yussefz99/Smart-Doorbell/Documentation/user_stories_smart_doorbell_final_trimmed.docx

Smart Doorbell – Group 15

A smart IoT doorbell with a camera that sends real-time photo notifications, recognises returning visitors, and lets the homeowner monitor and manage all door activity remotely via Telegram.

User Types

User Type | Description
Homeowner (Admin) | Full access: receives notifications, views history, manages settings, registers known visitors, and controls all device behaviour.
Family Member | Can view notifications and visit history. Cannot change settings or manage visitor profiles.
Guest / Delivery Person | Interacts only via the physical doorbell button. No app or internet access required.

User Stories (sorted by importance to the project)

# | Story Name | As a... | I want... | So that...

1 | Doorbell Notification | Homeowner / Family Member | to receive an instant notification with a photo on my phone when someone rings the doorbell | I know who is at the door immediately, even when I'm not home
2 | Visitor Recognition | Homeowner | the system to automatically recognise returning visitors and display their name in the notification | I can see at a glance whether it is someone I know without comparing photos manually
3 | Register a Known Visitor | Homeowner | to register a person by name so the system recognises them in future visits | I stop receiving 'unknown visitor' alerts for people I know
4 | Visitor Acknowledgment | Homeowner / Family Member | to respond to a doorbell notification with a quick reply button ('On my way', 'Not home') | my response is logged with the visit and I do not need to type a message
5 | Visit History | Homeowner | to view a log of past visits with photos, timestamps, and my responses | I can review who came to my door and when, even after the fact
6 | Device Status Indicator | Homeowner / Guest | the LED on the device to clearly indicate when it is capturing a photo, and to signal errors with a distinct blink pattern | anyone near the door can tell at a glance whether the device is working correctly
7 | Notification Settings | Homeowner | to configure quiet hours during which doorbell notifications are delivered silently but still recorded | I am not disturbed at night while every ring is still saved in my history
8 | Visit Statistics | Homeowner | to see a summary of door activity over time (busiest hours, number of visits per day) | I can understand patterns at my entrance and spot unusual activity
9 | Mark a Visit | Homeowner | to tag any visit in the history as 'Expected', 'Unknown', or 'Suspicious' | I keep my visit log organised and can flag unusual events for follow-up
10 | Edge Case – Camera Failure | Homeowner | to receive a notification if the camera fails to capture a photo during a visit | I know a visit occurred even without a photo and can investigate the issue
11 | Admin / Technician Mode | Homeowner | to access a diagnostic view showing device uptime, WiFi signal, last sync time, and recent errors | I can troubleshoot device problems myself without physically accessing it
12 | Physical Doorbell Ring | Guest / Delivery Person | to press a physical button on the device to alert the homeowner | I can notify the resident of my arrival without needing an app or internet access
13 | Away Mode Auto-Reply | Homeowner | to turn on an 'Away Mode' with a preset message that automatically replies to a visitor when the doorbell is pressed | the caller gets an immediate response and it is logged with the visit, even when I am not available to answer myself

Links to References, Projects and Tutorials

# | Relevance to Our Project | Related to User Stories | Link

1 | ESP32-CAM Doorbell with Telegram – photo capture and notification on button press | 1, 4, 6, 12 | https://randomnerdtutorials.com/esp32-cam-telegram-photo-notification/
2 | Raspberry Pi Smart Doorbell – camera, button, and notification integration reference | 1, 5, 8, 9 | https://www.instructables.com/Raspberry-Pi-Smart-Video-Doorbell/
3 | Face recognition with pre-trained models (backend, no custom training) – visitor identification | 2, 3 | https://github.com/serengil/deepface
4 | Telegram Bot API – sending photos, inline keyboards, commands | 1, 4, 7, 8, 11 | https://core.telegram.org/bots/api
5 | Ring Doorbell – commercial product reference for feature scope and UX patterns | 1, 5, 7, 8 | https://ring.com/doorbell-cameras

List of Hardware Used

Final hardware in the built prototype. Controller confirmed from the available catalog; remaining parts are standard lab components.

# | Part / Function | Why We Need It

1 | ESP32-CAM with camera (+ USB-Serial adapter for flashing) ★ CONFIRMED | Core controller: built-in camera and WiFi. Captures photos on button press and sends them to the backend. Face recognition runs on the backend server — no processing on the microcontroller.
2 | Push button | Physical doorbell trigger pressed by the guest. Core hardware interaction — directly drives user stories #1 and #12.
3 | Built-in flash LED (GPIO 4) | Visual feedback of device state: lights while capturing a photo and blinks a distinct pattern on error. Supports story #6. Uses the ESP32-CAM's on-board LED — no extra GPIO required.
4 | 5V power supply / USB Micro cable | Powers the ESP32-CAM continuously via Micro USB — the device must always be on and ready to detect events.
5 | Breadboard + jumper wires + resistors | Prototyping and connecting the button to the ESP32-CAM. ESP32-CAM GPIO operates at 3.3V logic.
