yussefz99/Smart-Doorbell/(commit log)

2026-06-08 Add firmware, backend, dashboard, and project docs
    - ESP32 firmware steps 1-5 (button, WiFi+Telegram, camera, photo, complete V1)
    - FastAPI backend with SQLite, Telegram webhook, WebSocket live updates
    - Dashboard HTML and project planning/handoff docs
    - .gitignore to exclude secrets (.env), database, and runtime data
2026-06-08 Redact credentials from firmware and docs
    Replace real bot token, WiFi credentials, and chat ID with placeholders.
    [doorbell_step2_wifi_telegram.ino, doorbell_step2_wifi_telegram_test.ino, doorbell_step4_photo_telegram.ino, doorbell_step5_complete_v1.ino]
2026-06-10 Migrate backend from SQLite to Supabase Postgres
    - Replace sqlite3 with psycopg2 (RealDictCursor, %s placeholders, RETURNING)
    - Port stats queries to Postgres (FILTER, EXTRACT, CURRENT_DATE)
    - Use TIMESTAMPTZ/BOOLEAN column types; DATABASE_URL from .env
    - Drop demo-data seeding for the cloud database
    - Add Procfile for Railway deployment
2026-06-10 Bump psycopg2-binary to 2.9.10 for Python 3.13 wheels
    2.9.9 has no cp313 wheels, so Railway built it from source and the
    runtime image lacked libpq.so.5.
2026-06-10 Point ESP32 sketch at Railway backend; move credentials to secrets.h
    - BACKEND_URL set to the permanent Railway deployment
    - Credentials now included from gitignored secrets.h
    - Add secrets.h.example template for teammates
2026-06-10 Update session handoff for cloud migration
    Reflects current state: Railway + Supabase architecture, secrets
    handling, button soldering plan, missing hardware, known issues.
2026-06-10 Add TRIGGER_ON_BOOT demo mode to Step 5 sketch
    Fires one doorbell event after boot so the carrier's RESET button can
    demo the full pipeline before the GPIO 13 button is soldered.
2026-06-10 Single notification path: ESP32 uploads photo to backend
    The ESP32 was sending its own Telegram photo (with dead reply buttons
    hardcoded to visit 0) while the backend sent a second, photo-less
    notification. Now:
    - ESP32 posts the photo via multipart to /api/visits; direct Telegram
    send remains only as fallback when BACKEND_URL is empty
    - Backend builds Telegram photo links from PUBLIC_BASE_URL instead of
    localhost so Telegram can actually fetch them
2026-06-10 Flip camera output 180 degrees (module mounted rotated in carrier)
    [doorbell_step5_complete_v1.ino]
2026-06-10 Serve dashboard from FastAPI root with same-origin API URLs
    Dashboard now works at the Railway URL directly; file:// opening
    still falls back to localhost:8001 for local dev.
2026-06-10 Update handoff: V1 verified on hardware, dashboard live on Railway
2026-06-10 Store visit photos in Supabase Storage
    Railway's disk is ephemeral, so dashboard photo links died on every
    redeploy. Photos now upload to the public 'photos' bucket and the
    visit stores the absolute public URL; local-disk path remains as
    fallback when SUPABASE_URL/SUPABASE_SERVICE_KEY are unset.
2026-06-10 Bigger photo thumbnails + click-to-enlarge lightbox
    Thumbnails 44x36 -> 80x60 with hover zoom; clicking opens the photo
    full-size in an overlay (click anywhere or Esc to close).
2026-06-10 Add password gate to dashboard
    Read endpoints (visits, stats, device status, tag updates, admin) and
    the WebSocket now require X-Dashboard-Key matching DASHBOARD_PASSWORD.
    Device endpoints (visit POST, heartbeat) and the Telegram webhook stay
    open. The dashboard shows a lock screen once per device and stores the
    key in localStorage. Empty DASHBOARD_PASSWORD disables the gate.
2026-06-10 Add device heartbeat with online/offline status
    - Sketch: POST wifi_signal to /api/device/heartbeat every 60s (and
    once at boot); ~1s blocking per beat is acceptable for V1
    - Backend: /api/device/status computes online from heartbeat age
    (<150s); camera_ok now tied to liveness instead of hardcoded true
    - Dashboard: Doorbell Device online/offline card, Last Heartbeat
    label, Diagnostics auto-refresh every 15s while open
2026-06-11 Face recognition groundwork: lazy InsightFace module + health probe
    - recognition.py: buffalo_s (ONNX) loaded on first use only, returns
    normalized 512-d embeddings; min detection score 0.5
    - /api/recognition/health loads the model and reports process memory
    to verify Railway can host it
    - Supabase: pgvector enabled, visitors + visitor_embeddings tables,
    visits.visitor_id (created directly in the database)
    - Camera bumped QVGA -> VGA for usable face detail
2026-06-11 Install OpenCV runtime libs in the Railway image
    cv2 import failed with missing libxcb.so.1 — the minimal railpack
    image lacks the X11/GL shared libraries OpenCV links against.
2026-06-11 Handoff: face recognition feasibility proven on Railway
2026-06-11 Park face recognition: off by default, documented enable/remove paths
    Recognition now requires explicit RECOGNITION_ENABLED=1. Avoids the
    ~600 MB resident model burning Railway trial credit while the team
    decides whether to keep the feature. Handoff documents both the
    one-variable enable and the full removal checklist.
2026-06-11 Quiet hours, delete-visit, and doorbell sound for the dashboard
    - Settings API (GET/PUT /api/settings) backed by a settings table;
    quiet window supports wrapping past midnight, Asia/Jerusalem time
    - During quiet hours visits are recorded as silent and the Telegram
    message is delivered with disable_notification (no sound on phone)
    - Settings page now only shows real controls (quiet hours + bot
    status); dead toggles removed; changes auto-save
    - DELETE /api/visits/:id removes the visit and its stored photo;
    trash button per row, lives across WebSocket clients
    - Two-tone WebAudio ding when a visit arrives while dashboard open
2026-06-16 Show count of dashboards currently connected
    Adds a live presence indicator so a user can notice when another
    device is also signed into the dashboard. The server already tracks
    open WebSocket connections; it now broadcasts the count on every
    connect/disconnect, and the sidebar shows "Only this device" or a
    highlighted "N devices connected".
2026-06-27 Add visitor-facing reply display (OLED) + backend response endpoint
    - backend: GET /api/visits/{id}/response so the doorbell can poll for
    the homeowner's Telegram reply ("On my way" / "Not home")
    - ESP32: new doorbell_step5_btn_io14 sketch — button on IO13+GND,
    128x64 OLED on IO14/IO15 showing status and the homeowner's reply
    - fix debounce bug (press edge never detected) in both step5 sketches
    - add i2c_scanner diagnostic sketch
    - update PLAN.md: V1 complete on CS-CAM hardware
    [doorbell_step5_btn_io14.ino, i2c_scanner.ino]
2026-06-27 OLED: SH1106 driver, hold reply ~11s, tunable X offset
    - switch display driver to SH1106 (fixes edge offset/garbage)
    - keep the homeowner's reply on screen ~11s for the visitor to read
    - add OLED_X define to nudge text horizontally on SH1106 panels
    [doorbell_step5_btn_io14.ino]
2026-06-27 docs: drop speaker (pin budget); recognition is now Phase 3 with OLED name display
2026-06-27 firmware: visitor greeting + word-wrap reply; add wiring docs
    - OLED greets by name when recognised ("New visitor" fallback) — REC-06 firmware
    - showReply() word-wraps the homeowner reply (supports free-typed text)
    - Documentation/connection diagram: WIRING.md + wiring-diagram.svg (DOC-01 hw)
2026-06-27 SEC-03: firmware sends X-Device-Key on all device requests
    - add X-Device-Key header to visit POST, heartbeat, and reply poll
    - value from SECRET_DEVICE_KEY (must match backend DEVICE_SECRET);
    #ifndef fallback so it compiles before the value is agreed
    - document SECRET_DEVICE_KEY in secrets.h.example
    Backend enforcement (SEC-01/02/04/05/06, REL-01) is Rami's to continue.
2026-06-27 docs: reconcile PLAN.md with real build + add demo runbook (DOC-01/02)
    - PLAN.md: Current Status (OLED, homeowner reply, greeting, SEC-03,
    wiring docs, audio dropped) + Next Actions matching the 4-phase roadmap
    - Documentation/DEMO-RUNBOOK.md: pre-demo checklist, the press->reply->
    dashboard script, and 7 recovery steps
    Firmware/hardware half of DOC-01 + DOC-02; backend/recognition docs stay Rami's.
2026-06-27 backend: accept typed replies to the doorbell message
    telegram_webhook now handles a text message that *replies* to the doorbell
    photo (matched via telegram_message_id) and saves it as the visit response —
    in addition to the existing inline-button taps. The visitor OLED already
    word-wraps the reply text.
2026-06-27 firmware: non-blocking reply watch so typed/late replies reach the OLED
    Replace the 45s blocking poll with a background watcher in loop(): after a
    visit, poll /api/visits/{id}/response every 4s for up to 3 min and show the
    reply whenever it arrives (tapped or typed). Device stays responsive while
    waiting. waitForHomeownerReply() -> single-poll fetchReply().
    [doorbell_step5_btn_io14.ino]
2026-06-27 dashboard: remove dead motion controls (button-only doorbell)
    Drop the always-empty Motion filter, the Motion chart toggles, and the
    Motion Triggers stat cards; swap the visit-stats card for a Replies count.
    Motion was dropped from the project (no sensor).
2026-06-27 feat(02-01): add require_device_key dependency + DEVICE_SECRET
    Mirrors require_dashboard_key: empty DEVICE_SECRET = gate disabled so the
    backend deploys without breaking the live device. Raises 401 only when the
    secret is set and X-Device-Key mismatches. (SEC-01/02/06 groundwork)
2026-06-27 feat(02-01): require X-Device-Key on visits, heartbeat, response poll
    Attach require_device_key to the 3 device routes (SEC-01/02/06). Verified live:
    gate ON -> 401 without/with wrong key, 200 with correct; gate OFF (empty
    DEVICE_SECRET) -> 200, so the live device keeps working until the secret is set.
2026-06-27 docs(03-visitor-recognition): create phase plan
    3 backend plans (Rami): pin face deps (REC-02), add visitor_name to
    /response (REC-06 backend), validate buffalo_s memory + accuracy and
    make the Railway enablement decision (REC-04/REC-05). REC-01 spike
    already GO; REC-03 frontend + REC-06 firmware are teammate-owned (Yussef).
2026-06-27 feat(03-01): pin face-recognition deps to exact versions (REC-02)
    insightface==1.0.1, onnxruntime==1.27.0, opencv-python-headless==4.13.0.92,
    psutil==7.2.2, numpy==2.4.6 — the versions validated in the REC-01 spike.
    Reproducible deploys + supply-chain mitigation. Recognition code untouched.
2026-06-27 feat(03-02): add visitor_name to GET /api/visits/{id}/response (REC-06 backend)
    LEFT JOIN visitors so the device reply poll returns {id, response, visitor_name}
    (handshake #2) for the OLED greeting. Additive only; id/response unchanged, 404
    and require_device_key auth preserved. Verified live: 3 keys present, 404 works.
2026-06-27 test(03-03): REC-04 memory (buffalo_s 672MB) + REC-05 accuracy validation
    REC-04: /api/recognition/health reports process_rss_mb=672 for buffalo_s (matches
    the ~600MB CLAUDE.md caution); prod go/keep-off pending the Railway operator check.
    REC-05: against the live DB, same-person re-recognizes (A_2 -> A_1 id, is_new=False),
    B/C don't false-match at MATCH_THRESHOLD=0.40, fail-open confirmed; test rows cleaned up.
    No runtime code changed. (.env RECOGNITION_ENABLED=1 is local-only, gitignored.)
2026-06-27 docs(03): add REC-01 feasibility spike + GO result
    rec01_spike.py runs the production recognition path over real ESP32-CAM photos;
    REC-01-RESULT.md records the GO gate (6/6 faces, same-person 0.638+ vs diff 0.211,
    threshold 0.40). Visitor face photos stay gitignored.
2026-06-28 dashboard: visitor profile modal with stats + visit history
    Click a visitor (photo or meta) on the Known Visitors page to open a profile:
    header (photo, name, known-since, last-seen), stat cards (total visits, reply
    rate, logged count), and a full visit-history timeline built from the loaded
    visits (filtered by visitor_id). No backend change.
2026-07-19 feat(backend): add Away Mode auto-reply
    New Settings toggle + preset message. When Away Mode is on, a bell press auto-fills the visit's response field with the preset text right after the notification is sent — reusing the existing reply round-trip, so it surfaces on the dashboard, the OLED /response poll, and Telegram (buttons replaced with the auto-reply).
    Settings table self-migrates the away_enabled/away_message columns via ALTER TABLE IF NOT EXISTS; PUT /api/settings treats them as optional so partial/older clients keep working. The auto-reply is wrapped in try/except and never blocks visit creation.
2026-07-19 docs: add Away Mode Auto-Reply user story (#13)
    Appends the Away Mode feature to the user-stories table as story #13, cloning the existing row formatting. Appended (not inserted) to avoid renumbering, which would break the story-number cross-references in the References table.
2026-07-19 chore: organize repo — remove junk, tidy root, drop flutter_app
    - Delete empty placeholder files (the various 'files here.txt', the 2-byte Fritzing placeholder) and the unused ESP32/SECRETS.h Google-Speech leftover (no real credentials; the real firmware uses gitignored secrets.h).
    - Move dev docs (PLAN.md, PROGRESS.md, SESSION_HANDOFF.md) off the repo root into Documentation/ and fix the README references, so the root reads cleanly.
    - Remove the empty flutter_app/ placeholder (README already marked it 'not part of V1').
2026-07-19 feat(esp32): add doorbell_final sketch as the canonical build
    Copy of doorbell_step5_btn_io14 (button on IO13 + OLED status), renamed to doorbell_final/doorbell_final.ino so the demo's final firmware is unambiguous. Byte-identical logic; only the header title differs. Original btn_io14 left untouched.
2026-07-19 docs: designate doorbell_final as the canonical build + add process-flow diagram
    Point README and CLAUDE.md's high-level firmware references at ESP32/doorbell_final (button + OLED) as the final/demo build, noting the doorbell_step5_* sketches are earlier iterations. Deep line-referenced sections still describe the complete_v1 iteration and are left as-is to keep their line numbers accurate. Also track Documentation/process-flow.svg.
2026-07-20 chore(esp32): keep only doorbell_final; move dev sketches to Unit Tests
    ESP32/ now contains only the final demo build (doorbell_final). Deleted the 6 step sketches that were byte-identical duplicates of the Unit Tests copies, dropped the superseded complete_v1 (kept in Unit Tests; ESP32 variant remains in git history), and removed the unused parameters.h. Moved doorbell_step5_btn_io14, i2c_scanner, compiled_program.bin, and the export how-to into Unit Tests. Updated README + CLAUDE.md references.
2026-07-20 docs: add configurable firmware parameters reference
    Document every tunable at the top of doorbell_final.ino (secrets, backend URL, pins, OLED driver, behaviour flags, timing, camera quality) in Documentation/CONFIGURABLE-PARAMETERS.md, with a quick-start checklist. Kept as a doc in Documentation/ rather than a separate top-level folder.
2026-07-20 chore(esp32): flatten final sketch to ESP32/ESP32.ino
    Move the final firmware out of the redundant doorbell_final/ subfolder so it sits directly in ESP32/ as ESP32.ino (valid Arduino layout: folder name = sketch name). Updated README, CLAUDE.md, and CONFIGURABLE-PARAMETERS.md references. secrets.h stays gitignored.
